saengowp/crowd-density-monitor/frontend/Images/footage.jpg

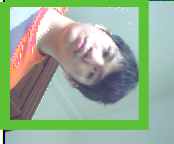
frontend/Images/footage.jpg
