saengowp/crowd-density-monitor/frontend/Images/temp.jpg

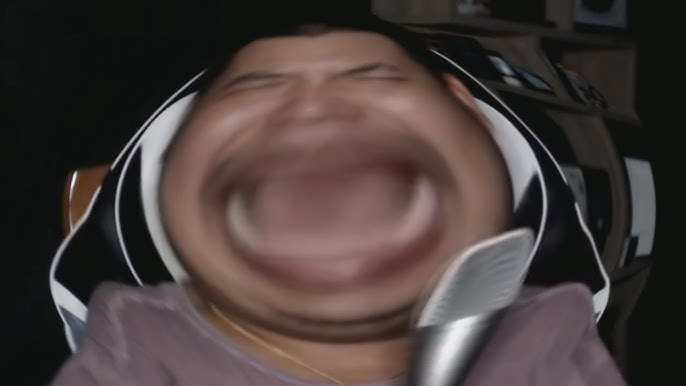
frontend/Images/temp.jpg
