saengowp/crowd-density-monitor/hardware/poc/crowdwatch/Doc/CameraIO.png

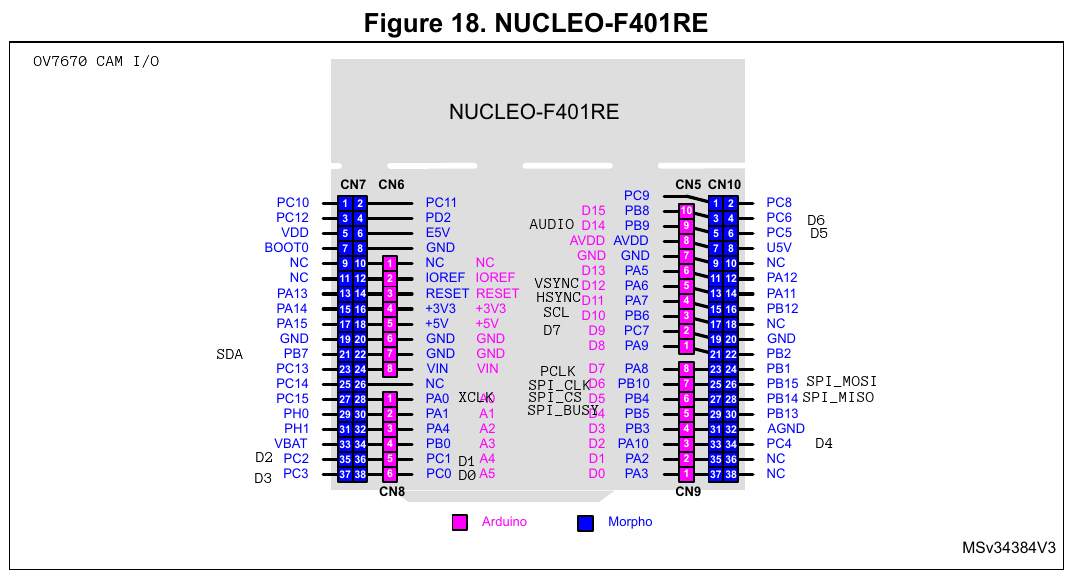
hardware/poc/crowdwatch/Doc/CameraIO.png
