saengowp/crowd-density-monitor/hardware/poc/AudioTest/wiring.md

Wiring
--------------------

CS -> 3.3V
IN- -> GND
PWM -> 530R -> IN+ -> 10kR --> IN+
                |--> 2.2nF Cap --> GND
GND -> GND
VCC -> 3.3V
SP+ -> Speaker -> SP-
