saengowp/crowd-density-monitor/hardware/poc/CamTest2/Wiring.txt

Wiring
---------------

PB4 --> 5KΩ --> XCLK --> 30KΩ --> GND
PA10 --> VS(ync)
PA8 --> PCLK
(PC0 - PC7) --> (D0 - D7)
PA1 --> HS(ync)
0V --> PWDN
3.3V --> RST
3.3V --> 3.3V
GND --> GND
