saengowp/crowd-density-monitor/hardware/poc/CamTest2/sample/tmp1cqv82qw.PNG

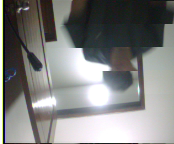
hardware/poc/CamTest2/sample/tmp1cqv82qw.PNG
