saengowp/crowd-density-monitor/hardware/poc/CamTest2/sample/tmp3ji6ege0.PNG

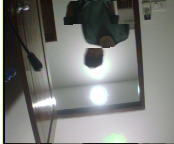
hardware/poc/CamTest2/sample/tmp3ji6ege0.PNG
