saengowp/crowd-density-monitor/hardware/poc/CamTest2/sample/tmp3r2begv8.PNG

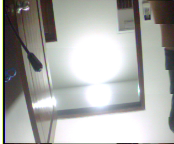
hardware/poc/CamTest2/sample/tmp3r2begv8.PNG
