saengowp/crowd-density-monitor/hardware/poc/CamTest2/sample/tmp3uqgu46l.PNG

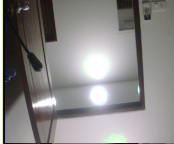
hardware/poc/CamTest2/sample/tmp3uqgu46l.PNG
