saengowp/crowd-density-monitor/hardware/poc/CamTest2/sample/tmp4jik7st7.PNG

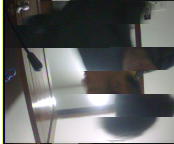
hardware/poc/CamTest2/sample/tmp4jik7st7.PNG
