saengowp/crowd-density-monitor/hardware/poc/CamTest2/sample/tmp7gmg07m6.PNG

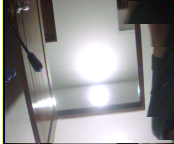
hardware/poc/CamTest2/sample/tmp7gmg07m6.PNG
