saengowp/crowd-density-monitor/hardware/poc/CamTest2/sample/tmp9fofpxp5.PNG

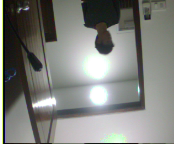
hardware/poc/CamTest2/sample/tmp9fofpxp5.PNG
