saengowp/crowd-density-monitor/hardware/poc/CamTest2/sample/tmp9mn9gzkz.PNG

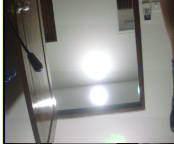
hardware/poc/CamTest2/sample/tmp9mn9gzkz.PNG
