saengowp/crowd-density-monitor/hardware/poc/CamTest2/sample/tmp75orkw3h.PNG

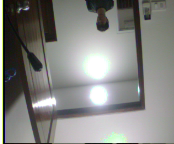
hardware/poc/CamTest2/sample/tmp75orkw3h.PNG
