saengowp/crowd-density-monitor/hardware/poc/CamTest2/sample/tmp_lic9cy2.PNG

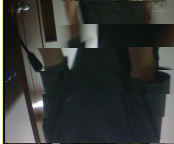
hardware/poc/CamTest2/sample/tmp_lic9cy2.PNG
