saengowp/crowd-density-monitor/hardware/poc/CamTest2/sample/tmpcz1fvvbb.PNG

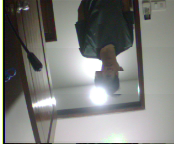
hardware/poc/CamTest2/sample/tmpcz1fvvbb.PNG
