saengowp/crowd-density-monitor/hardware/poc/CamTest2/sample/tmpeetpwtkq.PNG

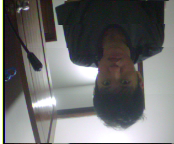
hardware/poc/CamTest2/sample/tmpeetpwtkq.PNG
