saengowp/crowd-density-monitor/hardware/poc/CamTest2/sample/tmpfa1veicp.PNG

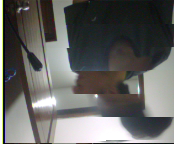
hardware/poc/CamTest2/sample/tmpfa1veicp.PNG
