saengowp/crowd-density-monitor/hardware/poc/CamTest2/sample/tmpfaspiwtu.PNG

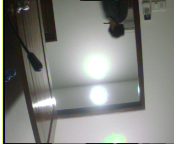
hardware/poc/CamTest2/sample/tmpfaspiwtu.PNG
