saengowp/crowd-density-monitor/hardware/poc/CamTest2/sample/tmpgamek3vy.PNG

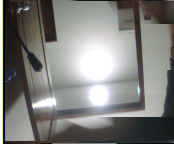
hardware/poc/CamTest2/sample/tmpgamek3vy.PNG
