saengowp/crowd-density-monitor/hardware/poc/CamTest2/sample/tmplptddnjl.PNG

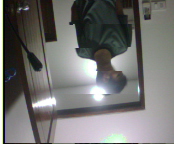
hardware/poc/CamTest2/sample/tmplptddnjl.PNG
