saengowp/crowd-density-monitor/hardware/poc/CamTest2/sample/tmpq6vzfb70.PNG

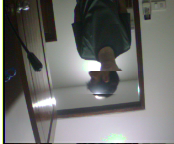
hardware/poc/CamTest2/sample/tmpq6vzfb70.PNG
