saengowp/crowd-density-monitor/hardware/poc/CamTest2/sample/tmpr67114ju.PNG

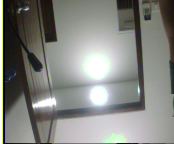
hardware/poc/CamTest2/sample/tmpr67114ju.PNG
