saengowp/crowd-density-monitor/hardware/poc/CamTest2/sample/tmpth_2hwkk.PNG

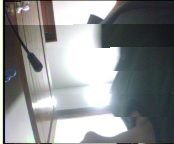
hardware/poc/CamTest2/sample/tmpth_2hwkk.PNG
