saengowp/crowd-density-monitor/hardware/poc/CamTest2/sample/tmpud2e6sd_.PNG

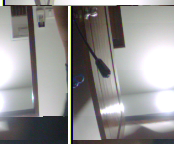
hardware/poc/CamTest2/sample/tmpud2e6sd_.PNG
