saengowp/crowd-density-monitor/hardware/poc/CamTest2/sample/tmpzvdfmo51.PNG

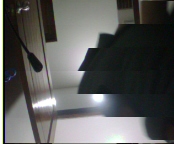
hardware/poc/CamTest2/sample/tmpzvdfmo51.PNG
