saengowp/crowd-density-monitor/hardware/poc/crowdwatch/Core/Src/main.c

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
/* Includes ------------------------------------------------------------------*/
#include "main.h"

/* USER CODE BEGIN Includes */

#include "cwsys/cwsys.h"

/* USER CODE END Includes */

I2C_HandleTypeDef hi2c1;

SPI_HandleTypeDef hspi2;

TIM_HandleTypeDef htim1;
TIM_HandleTypeDef htim2;
TIM_HandleTypeDef htim3;
TIM_HandleTypeDef htim4;
TIM_HandleTypeDef htim5;
DMA_HandleTypeDef hdma_tim1_ch1;

UART_HandleTypeDef huart2;

void SystemClock_Config(void);
static void MX_GPIO_Init(void);
static void MX_DMA_Init(void);
static void MX_USART2_UART_Init(void);
static void MX_I2C1_Init(void);
static void MX_TIM1_Init(void);
static void MX_TIM2_Init(void);
static void MX_TIM3_Init(void);
static void MX_SPI2_Init(void);
static void MX_TIM4_Init(void);
static void MX_TIM5_Init(void);
/**
  * @brief  The application entry point.
  * @retval int
  */
int main(void)
{
  /* MCU Configuration--------------------------------------------------------*/

  /* Reset of all peripherals, Initializes the Flash interface and the Systick. */
  HAL_Init();

  /* Configure the system clock */
  SystemClock_Config();

  /* Initialize all configured peripherals */
  MX_GPIO_Init();
  MX_DMA_Init();
  MX_USART2_UART_Init();
  MX_I2C1_Init();
  MX_TIM1_Init();
  MX_TIM2_Init();
  MX_TIM3_Init();
  MX_SPI2_Init();
  MX_TIM4_Init();
  MX_TIM5_Init();
  /* USER CODE BEGIN 2 */

  // Configure and run CrowdWatch
  struct cwsys_init_params cwsys_param = {
		  .infoSerial = &huart2,
		  .cameraParams = {
				  .tim1Sync = &htim1,
				  .tim3Sync = &htim3,
				  .camClkPwm = &htim2,
				  .pixdma = &hdma_tim1_ch1,
				  .pixDataGPIOIdr = &GPIOC->IDR,
				  .sccb = &hi2c1,
		  },
		  .espSpi = &hspi2,
		  .audioPwm = &htim4,
		  .audioTimer = &htim5,
  };
  cwsys(cwsys_param);
  /* USER CODE END 2 */

  /* Infinite loop */
  /* USER CODE BEGIN WHILE */
  while (1)
  {
    /* USER CODE END WHILE */

    /* USER CODE BEGIN 3 */
  }
  /* USER CODE END 3 */
}

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
