saengowp/crowd-density-monitor/hardware/poc/crowdwatch/Core/Inc/main.h

#define B1_Pin GPIO_PIN_13
#define B1_GPIO_Port GPIOC
#define CAM_XCLK_Pin GPIO_PIN_0
#define CAM_XCLK_GPIO_Port GPIOA
#define USART_TX_Pin GPIO_PIN_2
#define USART_TX_GPIO_Port GPIOA
#define USART_RX_Pin GPIO_PIN_3
#define USART_RX_GPIO_Port GPIOA
#define CAM_VSYNC_Pin GPIO_PIN_6
#define CAM_VSYNC_GPIO_Port GPIOA
#define CAM_HSYNC_Pin GPIO_PIN_7
#define CAM_HSYNC_GPIO_Port GPIOA
#define CAM_PCLK_Pin GPIO_PIN_8
#define CAM_PCLK_GPIO_Port GPIOA
#define TMS_Pin GPIO_PIN_13
#define TMS_GPIO_Port GPIOA
#define TCK_Pin GPIO_PIN_14
#define TCK_GPIO_Port GPIOA
#define SWO_Pin GPIO_PIN_3
#define SWO_GPIO_Port GPIOB
#define SPI_CS_Pin GPIO_PIN_4
#define SPI_CS_GPIO_Port GPIOB
#define SPI_BUSY_Pin GPIO_PIN_5
#define SPI_BUSY_GPIO_Port GPIOB
