saengowp/crowd-density-monitor/(commit log)

2021-05-28 hardware: crowdwatch: camera integration (ported from CamTest2)
2021-05-28 hardware: crowdwatch: camera io diagram
2021-05-29 hardware: crowdwatch: hack cam to ignore bad frame
2021-05-31 hardware: cwsys: more camera hack
2021-06-02 hardware: add spi demo
2021-06-02 hardware: preallocation audio pwm
2021-06-02 spi prototype
2021-06-02 hardware: esp err correct
    [cwsys.c, espcomodule.c, espcomodule.ino]
2021-06-02 hardware: integrate esp and camera
2021-06-02 switch to rest
2021-06-02 เปลี่ยนเลข กราฟ อุอิ
2021-06-02 current footage and count
